TheElectronicMusicProject/simple_audio_amplifier/(commit log)

2025-08-06 First design
    Feat: created the first working design.
    [simple_audio_amplifier.kicad_pcb, simple_audio_amplifier.kicad_sch]
2025-08-06 Added new part
    Feat: created symbol for PJ-322
    [simple_audio_amplifier.kicad_sch]
2025-08-07 Created fooprint + ERC + some footprint assignment
    Feat: created PJ-322 footprint
    Feat: created potentiometer footprint
    Fix: fixed all the ERC issues
    Feat: added further footprint assignments
    [simple_audio_amplifier.kicad_sch]
2025-08-07 Assigned all the footprints
    Feat: assigned a footprint to every component in the schematics.
    [simple_audio_amplifier.kicad_sch]
2025-08-07 Init PCB contraints
    Feat: added contraints related to JLCPCB
    [simple_audio_amplifier.kicad_pcb]
2025-08-08 Added component
    Feat: added further capacitor on the input power line.
    [simple_audio_amplifier.kicad_pcb, simple_audio_amplifier.kicad_sch]
2025-08-09 Component arrangement on the PCB
    Feat: identified a first positioning of the components on the PCB layout. Work in progress.
    [simple_audio_amplifier.kicad_pcb, simple_audio_amplifier.kicad_sch]
2025-08-11 New components + 3D assignments
    Feat: added input switch S1.
    Feat: added protection zenere D4.
    Feat: defined the terminal blocks J1, J3 with part number.
    Feat: added the 3D models where available.
    [simple_audio_amplifier.kicad_pcb, simple_audio_amplifier.kicad_sch]
2025-08-13 Put down traces on PCB layout
    Feat: connected all the nets in the PCB (no errors).
    Feat: added mounting hole components both on schematics and PCB.
    Docs: added the links for the components that will be used.
    [simple_audio_amplifier.kicad_pcb, simple_audio_amplifier.kicad_sch]
2025-08-18 Completition of the PCB + BOM
    Fix: changed the type of the rotary potentiometer to THT.
    Fix: changed the type of the input jack to THT and fixed the silkscreen.
    Feat: moved the general silkscreen to avoid any error/warning.
    Docs: released the BOM with a part number for every single component.
    [simple_audio_amplifier.csv, simple_audio_amplifier.kicad_pcb, simple_audio_amplifier.kicad_sch]
2025-08-20 Moved labels on schematics + more info on PCB
    Fix: moved the various label on the schematics to make it more readable.
    Docs: added board characteristics on PCB.
    Docs: added vertical and horizontal sizes on PCB.
    [simple_audio_amplifier.kicad_pcb, simple_audio_amplifier.kicad_sch]
2025-08-29 Completed the still WIP README
    Docs: added more chapters to the readme file, with a functional description of the circuit and notes for further development too.
2025-08-30 Modifications to the project docs
    Docs: added PCB layout.
    Docs: added licence section and Rev.1.1 description.
